Luigimash/LED_Matrix_Phone_Case/media/ver 1.0/top_main_display_board.webp

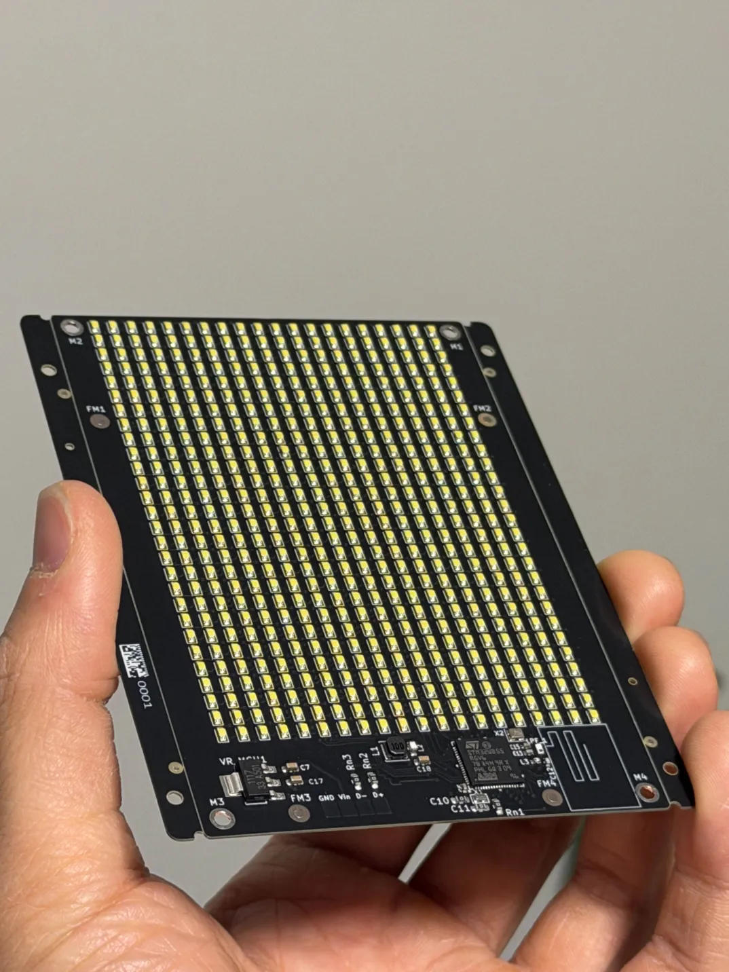
media/ver 1.0/top_main_display_board.webp
