Luigimash/LED_Matrix_Phone_Case/media/ver 1.0/bad_pads_main_display_board.png

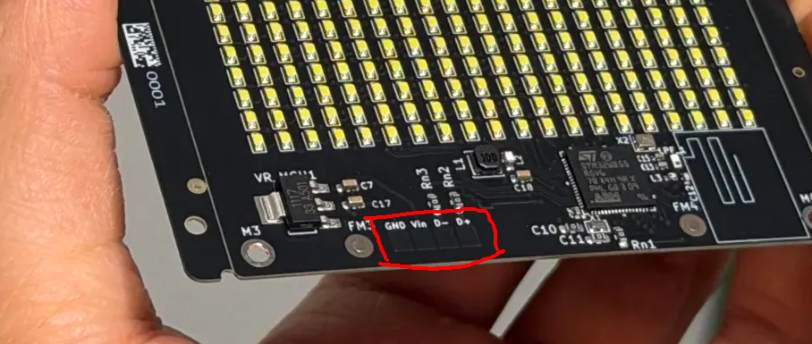
media/ver 1.0/bad_pads_main_display_board.png
