Luigimash/LED_Matrix_Phone_Case/media/ver 1.0/bottom_main_display_board.png

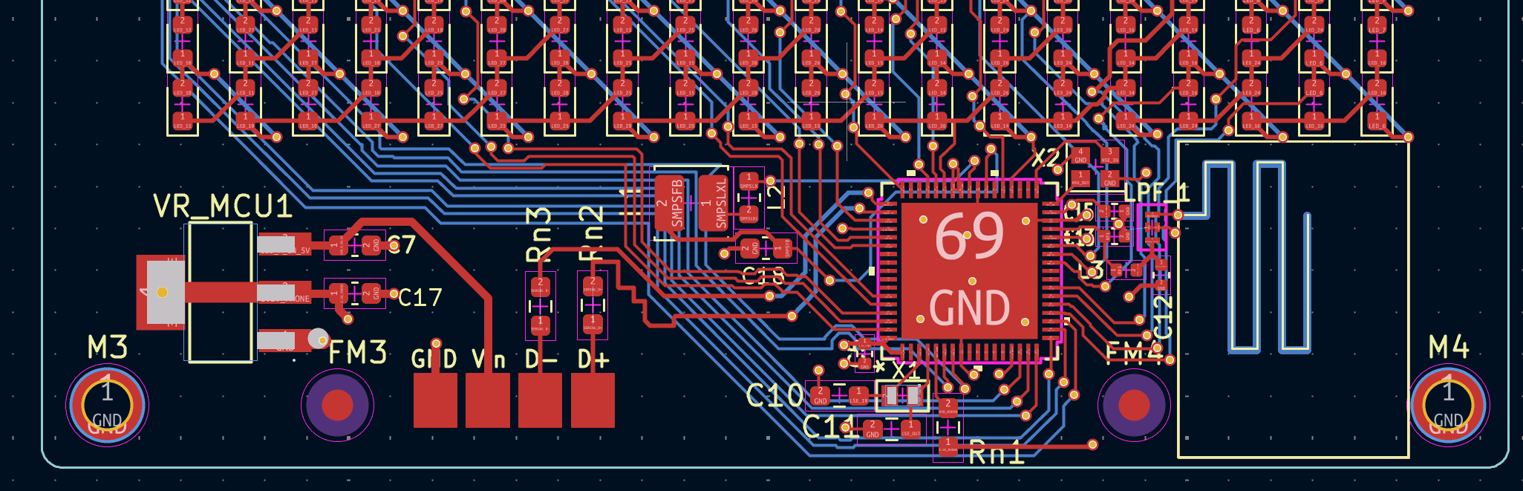
media/ver 1.0/bottom_main_display_board.png
