Luigimash/LED_Matrix_Phone_Case/media/ver 1.0/Example gif of the AniMe Matrix.gif

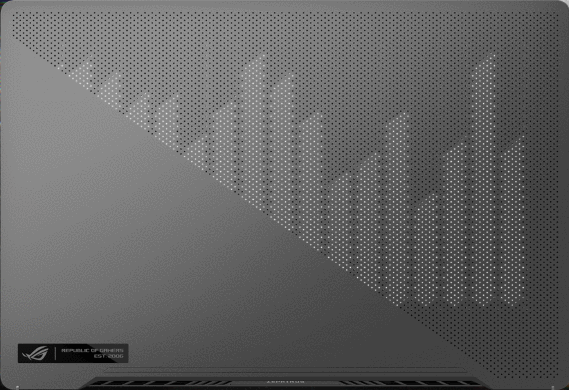
media/ver 1.0/Example gif of the AniMe Matrix.gif
