Luigimash/LED_Matrix_Phone_Case/media/ver 1.0/flex_usb_board.png

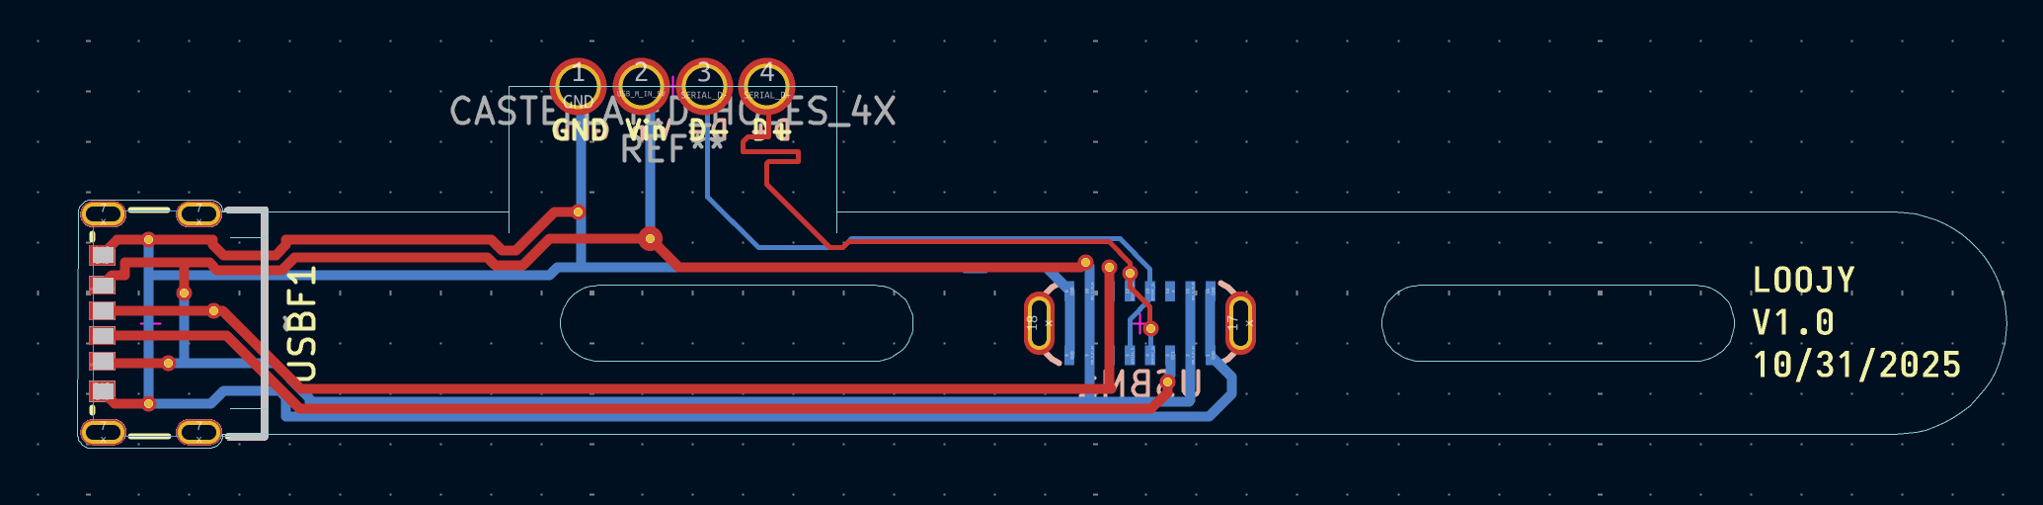
media/ver 1.0/flex_usb_board.png
