Luigimash/LED_Matrix_Phone_Case/media/ver 1.0/main_display_board_schem.jpg

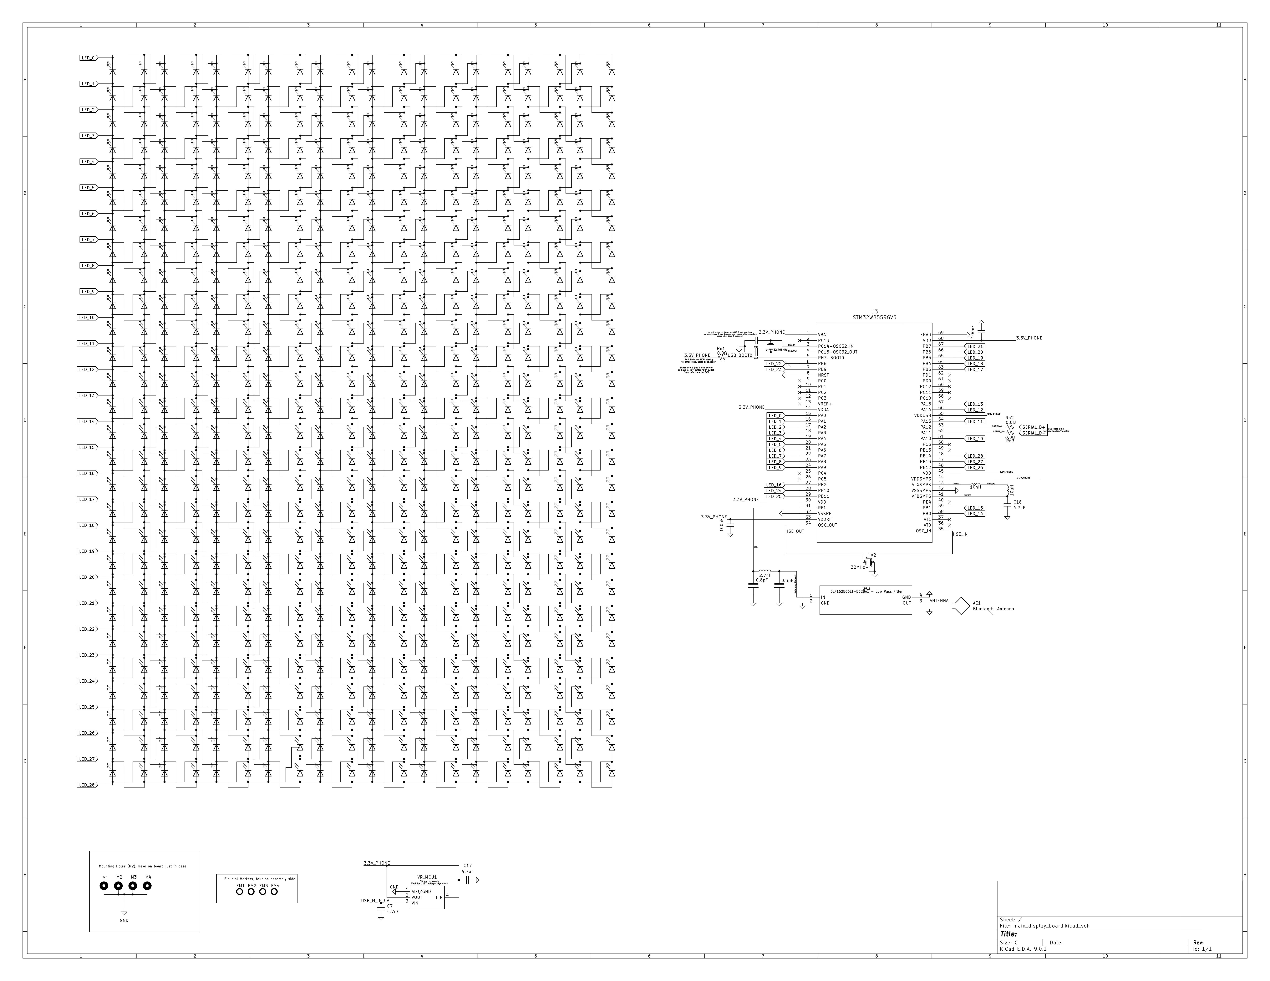
media/ver 1.0/main_display_board_schem.jpg
