Luigimash/LED_Matrix_Phone_Case/software/media_processor/GIF.gif

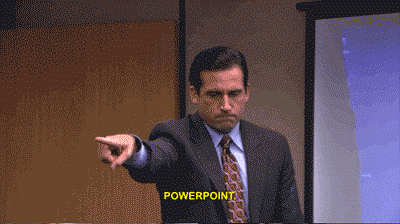
software/media_processor/GIF.gif
