Luigimash/LED_Matrix_Phone_Case/FABRICATION_OUTPUTS/flex_usb_board/BOM.csv

Comment | Designator | Footprint | Quantity | Designation | Supplier and ref | JLC Part #
-30℃~+80℃ 1 1.68mm 3A 5,000 Cycles 5V 6.8mm 6P Black Female Surface Mount, Right Angle Type-C SMD USB Connectors ROHS | USBF1 | TYPE-C-SMD_HANXIA_HX-TYPE-C-6P-SY | 1 | USB TYPE C FEMALE | HX TYPE-C 6P SY | C5178531
-40℃~+105℃ 1 16P 3A Male Surface Mount,Vertical Type-C USB 2.0 SMD USB Connectors ROHS | USBM1 | USB-C Male 918-118A2021Y40006 | 1 | USB TYPE C MALE | 918-118A2021Y40006 | C399938
