Luigimash/LED_Matrix_Phone_Case/Parts/DLF162500LT_5028A1/DLF-4_1P6X0P8.step

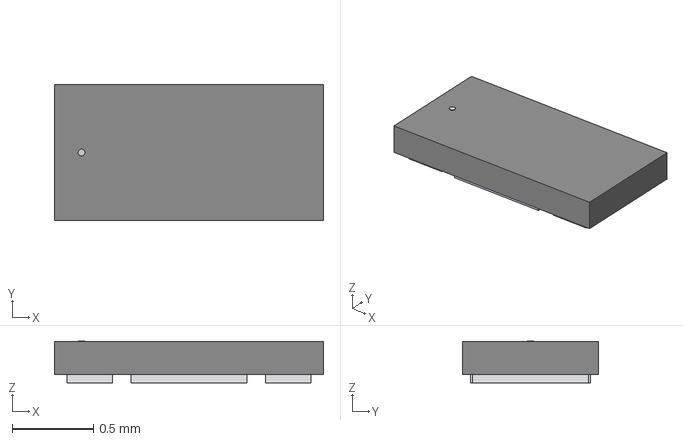
[picture p12: CAD file, 2025-10-10]
Parts/DLF162500LT_5028A1/DLF-4_1P6X0P8.step
1.65 x 0.838 x 0.257 mm
