Luigimash/LED_Matrix_Phone_Case/Parts/STM32WB55RGV6/VFQFN68-8x8mm.step

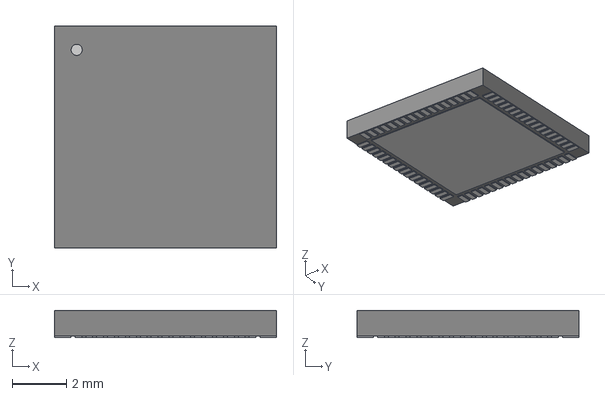
[picture p13: CAD file, 2025-10-10]
Parts/STM32WB55RGV6/VFQFN68-8x8mm.step
8.15 x 8.15 x 0.993 mm
