Luigimash/LED_Matrix_Phone_Case/Parts/TPS7A0233PDQNR/TPS7A0233PDQNR.step

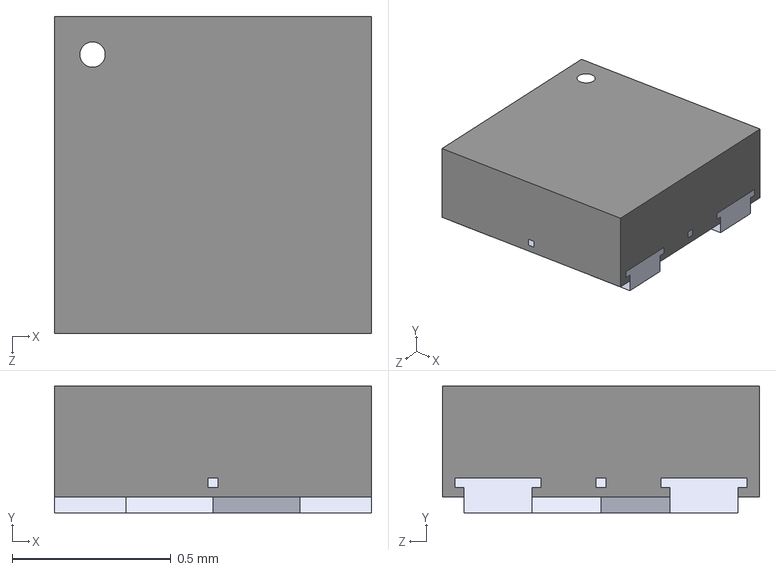
[picture p14: CAD file, 2025-10-10]
Parts/TPS7A0233PDQNR/TPS7A0233PDQNR.step
1.00 x 0.4 x 1.00 mm
