Luigimash/LED_Matrix_Phone_Case/LED_Matrix_Phone_Case.kicad_pcb

## KiCad design LED_Matrix_Phone_Case.kicad_pcb (2025-10-10)

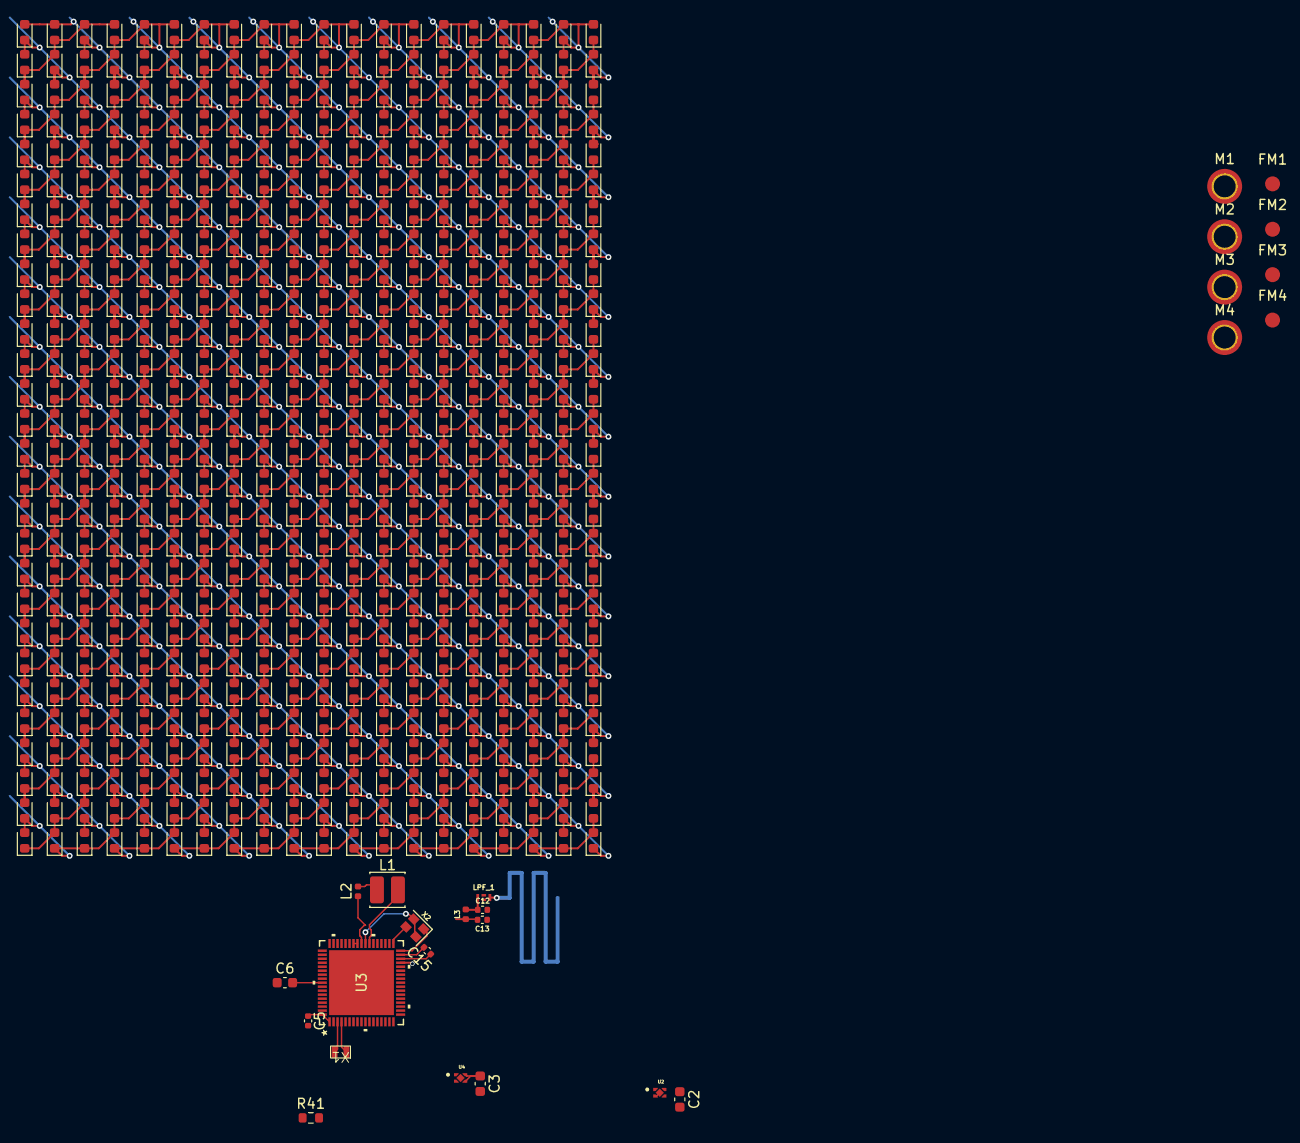
[picture p15: board LED_Matrix_Phone_Case.kicad_pcb from above]

Board: 2 copper layers, 25 parts (0 on the bottom side), 14 nets.

Parts:
C2, C3: 4.7uF; C_0603_1608Metric
C5, C15: 100nF; C_0402_1005Metric
C6: 4.7µF; C_0603_1608Metric
C12: 0.3pF; C_0402_1005Metric
C13: 0.8pF; C_0402_1005Metric
FM1, FM2, FM3, FM4: Fiducial; Fiducial_1.5mm_Mask3mm
L1: 10uH; L_Cenker_CKCS3015
L2: 10nH; L_0402_1005Metric
L3: 2.7nH; L_0402_1005Metric
LPF_1: DLF162500LT-5028A1 - Low Pass Filter; DLF-4_1P6X0P8
M1, M2, M3, M4: MountingHole_Pad; MountingHole_2.2mm_M2_ISO7380_Pad_TopBottom
R41: 5.1kΩ; R_0603_1608Metric
U2: TPS7A0233PDQNR_PHONE; IC_TPS7A0233PDQNR
U3: STM32WB55RGV6; VFQFN68-8x8mm
U4: TPS7A0233PDQNR_PC; IC_TPS7A0233PDQNR
X1: 32.768KHz; SMD1610
X2: 32MHz; Crystal_SMD_2016-4Pin_2.0x1.6mm

Connections:
/3.3V_PC: C6.2, U3.60 (PC12), U4.1 (OUT)
/3.3V_PHONE: C5.1, C15.2, U2.1 (OUT), U3.1 (VBAT), U3.14 (VDDA), U3.30 (VDD), U3.33 (VDDRF), U3.44 (VDDSMPS), U3.45 (VDD), U3.55 (VDDUSB), U3.68 (VDD)
/HSE_IN: U3.35 (OSC_IN), X2.3
/HSE_OUT: U3.34 (OSC_OUT), X2.1
/LSE_IN: U3.3 (PC14-OSC32_IN), X1.2
/LSE_OUT: U3.4 (PC15-OSC32_OUT), X1.1
/Matching_Network: C12.1, L3.2, LPF_1.1 (IN)
/RF1: C13.1, L3.1, U3.31 (RF1)
/SMPSFB: L1.2, U3.41 (VFBSMPS)
/SMPSLX: L2.1, U3.43 (VLXSMPS)
/SMPSLXL: L1.1, L2.2
/USB_F_IN_5V: C3.1, U4.3 (EN), U4.4 (IN)
/USB_M_IN_5V: C2.1, U2.3 (EN), U2.4 (IN)
GND: C2.2, C3.2, C5.2, C6.1, C12.2, C13.2, C15.1, LPF_1.2 (GND), LPF_1.4 (GND), M1.1, M2.1, M3.1, M4.1, R41.2, U2.2 (GND), U2.5 (THERMAL_PAD), U3.8 (NRST), U3.32 (VSSRF), U3.42 (VSSSMPS), U3.69 (EPAD), U4.2 (GND), U4.5 (THERMAL_PAD), X2.2, X2.4
