Luigimash/LED_Matrix_Phone_Case/(commit log)

2025-10-10 init commit
    [DLF-4_1P6X0P8.step, LED_Matrix_Phone_Case.kicad_pcb, LED_Matrix_Phone_Case.kicad_sch, TPS7A0233PDQNR.step, VFQFN68-8x8mm.step]
2025-11-08 ver 1.1 files, i fucked up the flex board to main board pads on v1.0 but fixed in 1.1
    [BOM.csv, BOM.ods, LED_Matrix_Phone_Case.kicad_sch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]
2025-11-09 generating pin-pixel mapping
2025-11-13 added stm32 generated code
